calebjnz/Oven-Controller/(list of files, cad)

Other CAD files:
buttonPogo v1.f3d
controllerBox v2.f3d
displayPanel v12.f3d
