calebjnz/Oven-Controller/(commit log)

2022-07-04 relay pin, slowfall and estOvershoot changed, not tested
2022-07-05 trying out PID
2022-07-06 Beans PID working i think
2022-07-06 Trying to reduce overshoot, and make slow fall prop
2022-07-06 Looking good, couple more tweaks
2022-07-08 CAD for control box
    [buttonPogo v1.f3d, controllerBox v2.f3d, displayPanel v12.f3d]
